SKZ81/ESP-FLAM/README.md

This is branch **master** (normal operation firmware)

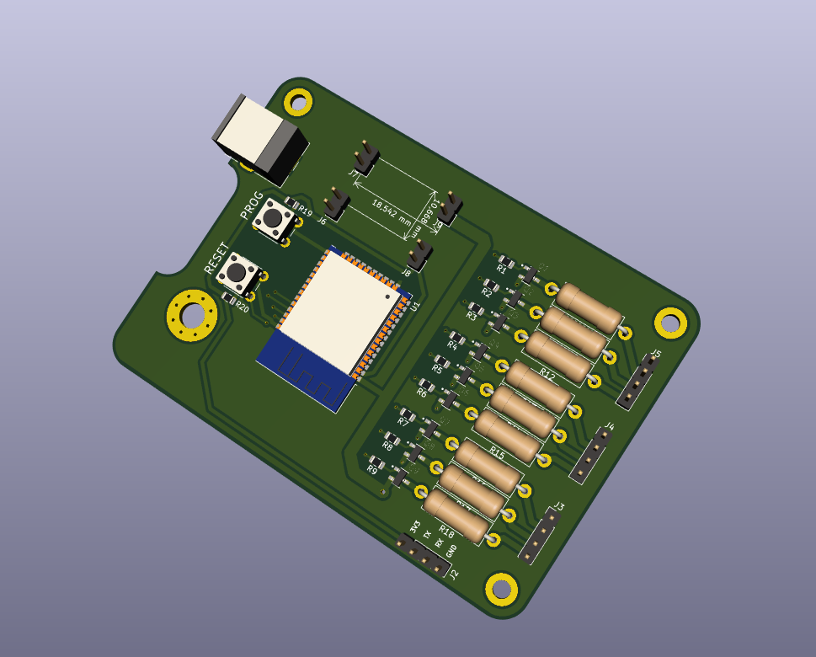
[picture p1: docs/images/ESP_Flam.png]
ESP_Flam
