SKZ81/ESP-FLAM/KiCAD/README.md

# ESP FLAM PCB

## Top Layer

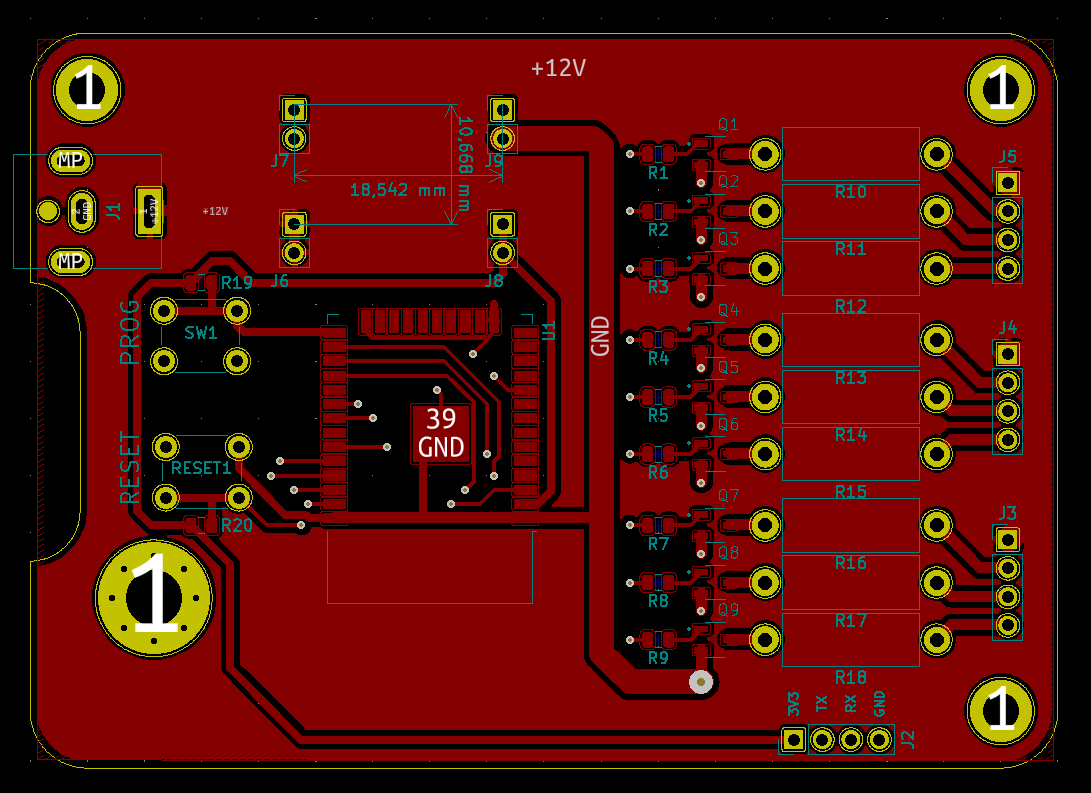
[picture p2: KiCAD/images/Top_layer.png]
Top_layer


## Bottom Layer

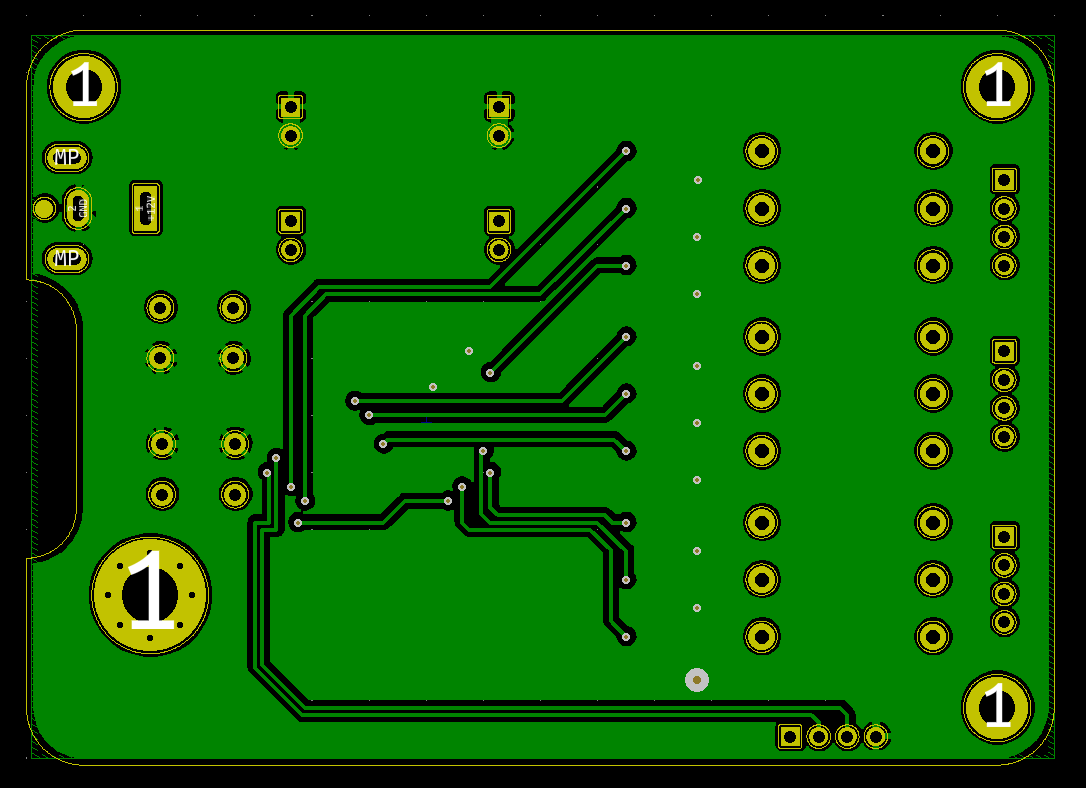
[picture p3: KiCAD/images/Bottom_layer.png]
Bottom_layer


## 3D View

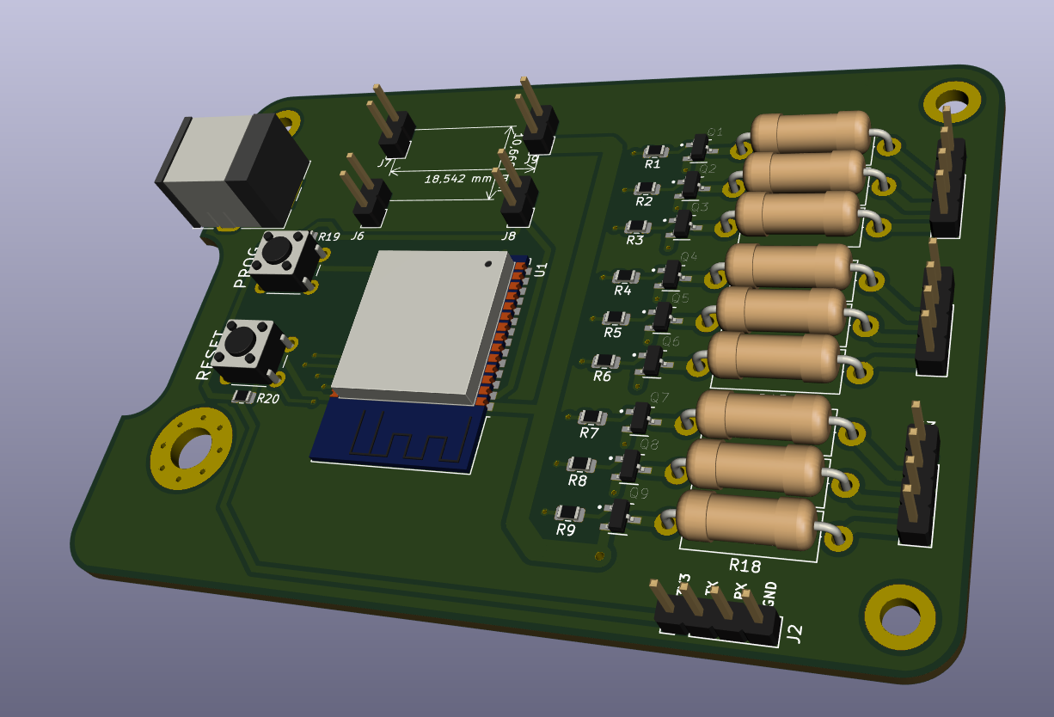
[picture p4: KiCAD/images/3D_view.png]
3D_view


## Real Board

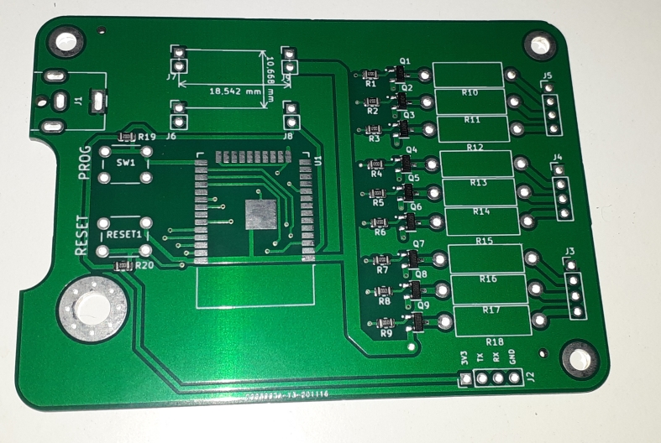
[picture p5: KiCAD/images/real_board_JLCPCB.jpg]
real_board_JLCPCB
