SKZ81/ESP-FLAM/KiCAD/ESP_Flam.kicad_pcb

## KiCad design KiCAD/ESP_Flam.kicad_pcb (2020-11-16)

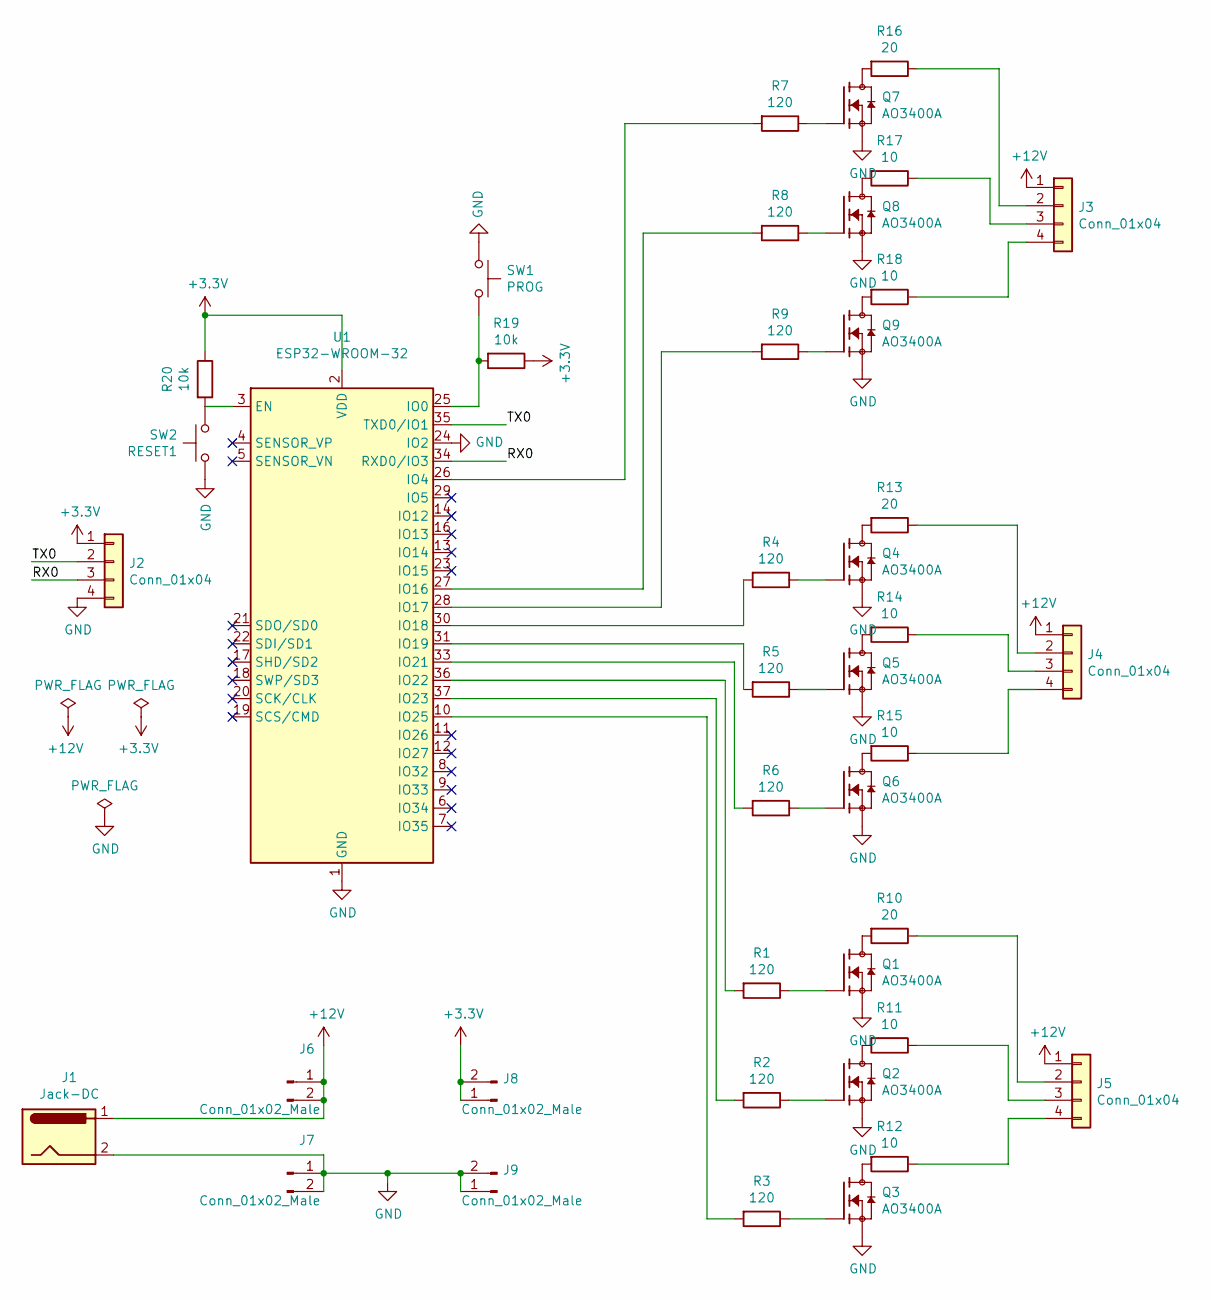
[picture p6: schematic ESP_Flam.sch]

Parts:
J1: Jack-DC; BarrelJack_CUI_PJ-063AH_Horizontal
J2, J3, J4, J5: Conn_01x04; PinHeader_1x04_P2.54mm_Vertical
J6, J7, J8, J9: Conn_01x02_Male; PinHeader_1x02_P2.54mm_Vertical
Q1, Q2, Q3, Q4, Q5, Q6, Q7, Q8, Q9: AO3400A; SOT95P280X125-3N; LCSC Part C347475
R1, R2, R3, R4, R5, R6, R7, R8, R9: 120; R_0805_2012Metric; LCSC Part C17437
R10, R13, R16: 20; R_Axial_DIN0414_L11.9mm_D4.5mm_P15.24mm_Horizontal
R11, R12, R14, R15, R17, R18: 10; R_Axial_DIN0414_L11.9mm_D4.5mm_P15.24mm_Horizontal
R19, R20: 10k; R_0805_2012Metric; LCSC Part C17414
RESET1: SW2; SW_PUSH_6mm
SW1: PROG; SW_PUSH_6mm
U1: ESP32-WROOM-32

Connections:
+3V3: J2.1, J8.1, J8.2, R19.1, R20.1, U1.2 (VDD)
+12V: J1.1, J3.1, J4.1, J5.1, J6.1, J6.2
/RX0: J2.3, U1.34 (RXD0/IO3)
/TX0: J2.2, U1.35 (TXD0/IO1)
GND: J1.2, J2.4, J7.1, J7.2, J9.1, J9.2, Q1.2 (S), Q2.2 (S), Q3.2 (S), Q4.2 (S), Q5.2 (S), Q6.2 (S), Q7.2 (S), Q8.2 (S), Q9.2 (S), RESET1.1, SW1.1, U1.1 (GND), U1.15 (GND), U1.24 (IO2), U1.38 (GND), U1.39 (GND)
unnamed: J3.2, R16.1
unnamed: J3.3, R17.1
unnamed: J3.4, R18.1
unnamed: J4.2, R13.1
unnamed: J4.3, R14.1
unnamed: J4.4, R15.1
unnamed: J5.2, R10.1
unnamed: J5.3, R11.1
unnamed: J5.4, R12.1
unnamed: Q1.1 (G), R1.1
unnamed: Q1.3 (D), R10.2
unnamed: Q2.1 (G), R2.1
unnamed: Q2.3 (D), R11.2
unnamed: Q3.1 (G), R3.1
unnamed: Q3.3 (D), R12.2
unnamed: Q4.1 (G), R4.1
unnamed: Q4.3 (D), R13.2
unnamed: Q5.1 (G), R5.1
unnamed: Q5.3 (D), R14.2
unnamed: Q6.1 (G), R6.1
unnamed: Q6.3 (D), R15.2
unnamed: Q7.1 (G), R7.1
unnamed: Q7.3 (D), R16.2
unnamed: Q8.1 (G), R8.1
unnamed: Q8.3 (D), R17.2
unnamed: Q9.1 (G), R9.1
unnamed: Q9.3 (D), R18.2
unnamed: R1.2, U1.36 (IO22)
unnamed: R2.2, U1.37 (IO23)
unnamed: R3.2, U1.10 (IO25)
unnamed: R4.2, U1.30 (IO18)
unnamed: R5.2, U1.31 (IO19)
unnamed: R6.2, U1.33 (IO21)
unnamed: R7.2, U1.26 (IO4)
unnamed: R8.2, U1.27 (IO16)
unnamed: R9.2, U1.28 (IO17)
unnamed: R19.2, SW1.2, U1.25 (IO0)
unnamed: R20.2, RESET1.2, U1.3 (EN)

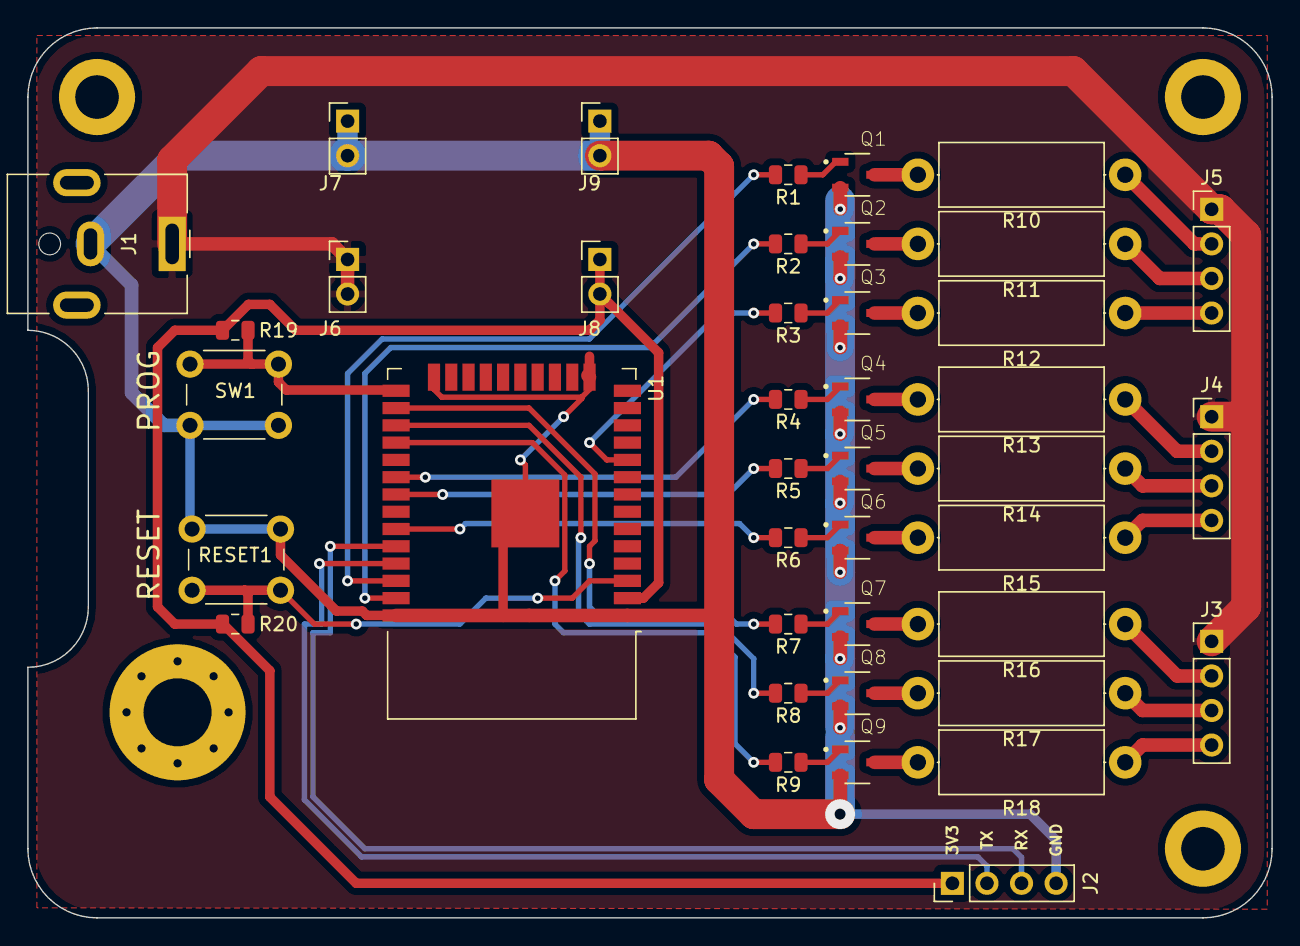
[picture p7: board ESP_Flam.kicad_pcb from above]

Board: 2 copper layers, 91.4 x 65.4 mm, 44 parts (0 on the bottom side), 43 nets.

Other parts of the board:
 : MountingHole_3.2mm_M3_DIN965_Pad
 #2,  #3: MountingHole_3.2mm_M3_DIN965_Pad
