SKZ81/ESP-FLAM/(commit log)

2020-12-01 Reorganized source tree
    [ESP_Flam.kicad_pcb, ESP_Flam.sch]
2020-12-03 Added baby 'Mode Manager'
    It haz :
    * a 'full-featured" fire effect
    * a blink effect (errors, connection to WiFi...)
    * A basic Web API (POST /fire and POST /firestop)
    * POST /fire takes a JSON with brightness, flickering, speed parameters
    * brightness is a multiplucation factor (% 0..1)
    * flickering factor defines how much a "candle" flickers in hue (red <-> yellow) (% 0..1)
    * speed is the duration (ms) between two calls of the animation fuction (BAD NAME !!)
    **SEARCH FOR TODOs**
    [main.c, mode_mngt.c, mode_mngt.h, pwm.c]
2020-12-31 double -> float (esp32's FPU handle them 10x faster)
    See (for instance) : https://github.com/espressif/arduino-esp32/issues/2538#issuecomment-490462322
    [mode_mngt.h]
2020-12-31 Added images & README for PCB
